rwb27/openflexure_nano_motor_controller/docs/hardware.rst

Sangaboard hardware
=====================
This module is designed to work with the "sangaboard" motor controller, 
based on an Arduino Nano and some Darlington pair ICs.  The PCB design
is available on Github, and can be ordered through WaterScope or via
`Kitspace`_.

.. _Kitspace: https://kitspace.org/boards/github.com/rwb27/openflexure_nano_motor_controller/
