rwb27/openflexure_nano_motor_controller/docs/source/openflexure_stage.rst

openflexure\_stage package
==========================

Submodules
----------

.. toctree::

   openflexure_stage.basic_serial_instrument
   openflexure_stage.stage

Module contents
---------------

.. automodule:: openflexure_stage
    :members:
    :undoc-members:
    :show-inheritance:
