rwb27/openflexure_nano_motor_controller/docs/source/openflexure_stage.stage.rst

openflexure\_stage.stage module
===============================

.. automodule:: openflexure_stage.stage
    :members:
    :undoc-members:
    :show-inheritance:
