rwb27/openflexure_nano_motor_controller/pcb_design/Schematic_v0.2.png

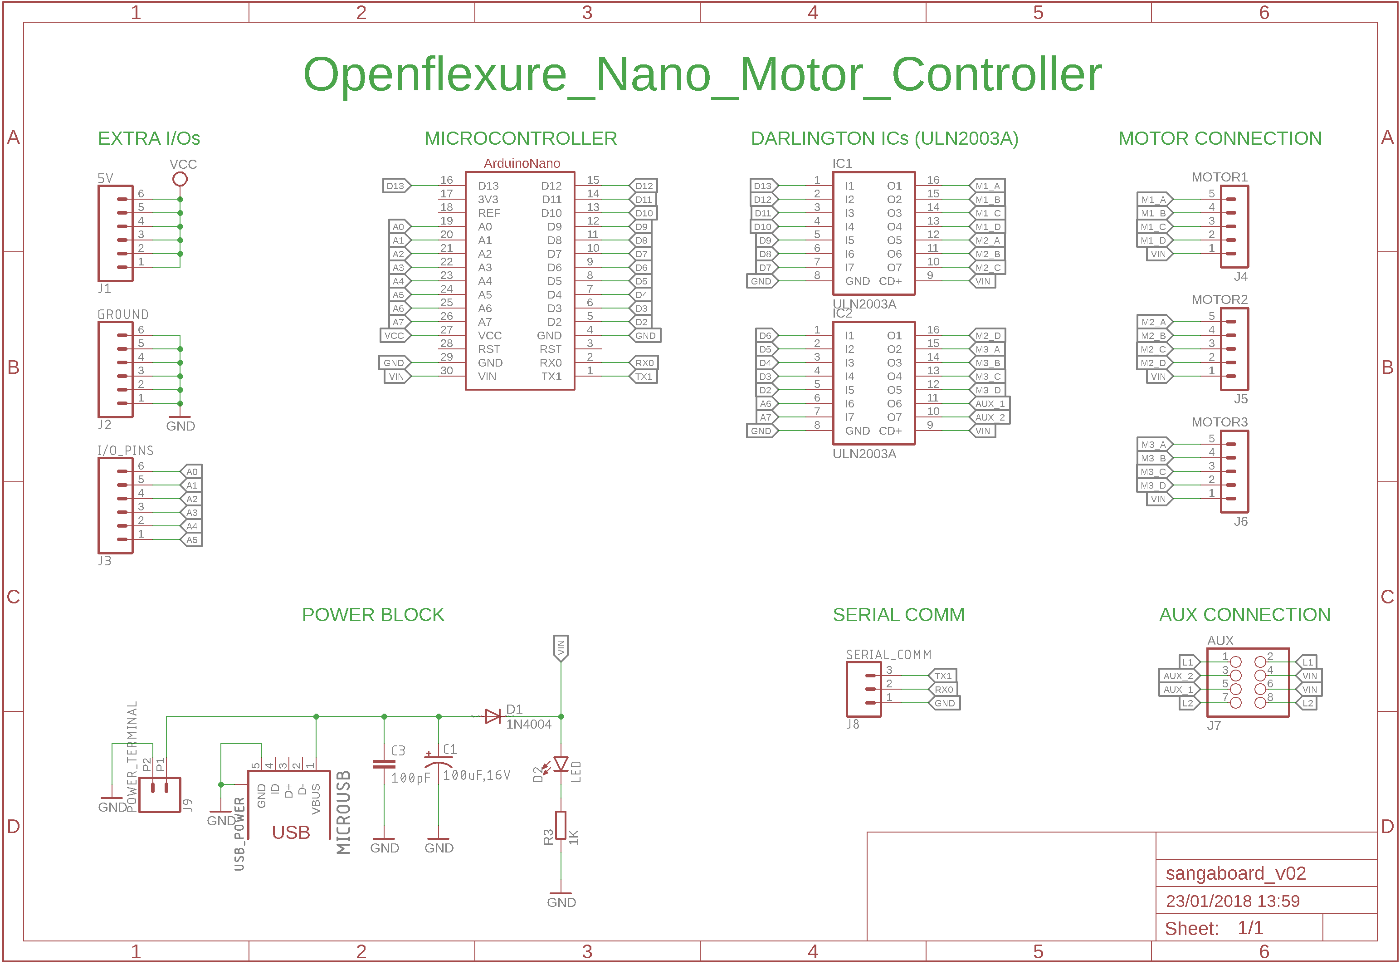
pcb_design/Schematic_v0.2.png
