rwb27/openflexure_nano_motor_controller/pcb_design/topView.png

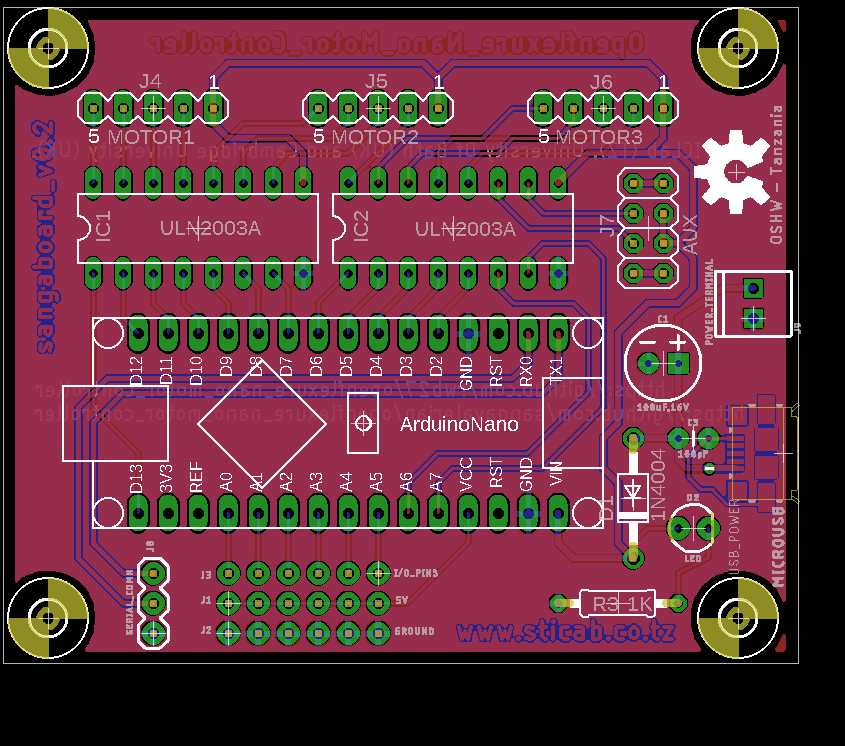
pcb_design/topView.png
