rwb27/openflexure_nano_motor_controller/(threads)

Thread 2 (2017-06-28):

Break out more pins

rwb27, 2017-06-28:
I’ve been thinking a bit more about this, and we might struggle for pins after all – Currently we have 14 channels of Darlington pair drivers (of which 12 are used).  Extra things we might like are:

1.	Limit switches (up to 3)
2.	LED control (using Darlington pair or, better, i2c-controlled digital potentiometers with constant-current drivers)
3.	Heater control (using one or two analogue pins plus a PWM pin for output, driving a power MOSFET)

The Nano has 14 digital pins of which 2 are the serial interface and 12 control the motors.  That leaves us 8 analogue pins to play with, which would be just enough to do the 3 things above, either using a digipot + constant current circuit for the LEDs or just the darlington pairs.

rwb27, 2017-10-03:
I think the two unused Darlington pairs are broken out now - though I don't know if that version has been uploaded (?)

rwb27, 2017-11-28:
I'm going to make a number of more specific issues for the next revision of the board.

rwb27, 2017-11-29:
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
While there are lots of nice suggestions for the next version, I think these are the most useful changes in the short term, and shouldn't be too much work...

sctv, 2017-12-11:
As few more suggestions.... for the future.

For LEDs you could use neopixels or similar.

https://create.arduino.cc/projecthub/whimsy-makerspace/arduino-compatible-nano-neopixel-controller-6f0c4b

On the nano analogue pins 1-6 can be used as digital if required ;)

"A0-A5 can be used as: analog input/digital input/digital output.
A6 and A7 are analog inputs only." (Via https://forum.arduino.cc/index.php?topic=502105.0

rwb27, 2017-12-13:
Thanks - that is useful.  I've shied away from the neopixels for the moment, largely because my experience with other multi-colour LEDs is that the colours come from different locations on the die - while that's not an issue in lighting/display applications, it can be a real pain in microscopy.

That said, we are looking at more sophisticated condenser designs that might include diffusers, at which point neopixels might be a very good option :)

sctv, 2017-12-14:
Its good to know about that disadvantage with multi led dies + microscopy.

On Wed, Dec 13, 2017 at 9:21 AM, Richard Bowman <notifications@github.com>
wrote:

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

--
----------------------------------------
Brian Degger
twitter: @drbrian

http://makerspace.org.uk
http://transitlab.org
----------------------------------------

sangavalerian, 2018-01-17:
thanks for the comments, i am finalizing version 0.2 of sangaboard (openflexure_nano_motor_controller). This time i have used eagle.

Thread 3 (2017-07-24):

Add Gerber files and BoM to repository

rwb27, 2017-07-24:
To get this made, most PCB houses need Gerber files, and a bill of materials.  It would be good to export these and put them in the repository.

rwb27, 2017-10-03:
Gerber files are here now.

rwb27, 2017-11-28:
I think this is now fixed - there should be everything we need to get it manufactured.

Closed 2017-11-28.

Thread 4 (2017-10-03):

ramp_time != 0 causes odd behaviour

rwb27, 2017-10-03:
setting ramp_time to a nonzero value seems to make the stage move back then forwards - this is odd...

rwb27, 2017-10-03:
actually, this is occurring even with ramp_time=0.  Maybe I've screwed up elsewhere...

rwb27, 2017-10-03:
oops! the error was in my Python code.  My backlash correction logic goes wrong when making steps smaller than the backlash amount.  Need to sort that out - I'll just turn it off for now.

Closed 2017-11-28.

Thread 11 (2017-11-28):

LED controller

rwb27, 2017-11-28:
It would be really useful to have a constant-current LED driver on the board.  A basic spec would be:
* 2 channels of illumination (more is a nice bonus but 2 is probably fine for now)
* adjustable current (ideally not using PWM).
  - Basic version: header pin to allow a resistor to be swapped in, and drive with 5v
  - Better version: integrate a trim pot
  - Best version: add an i2c digipot (if it's surface mount it might not cost much?)

Thread 12 (2017-11-28):

Heater control

rwb27, 2017-11-28:
It would be great to have 1-2 channels of heater control.  This probably wants some sort of digipot/pwm + MOSFET combination.  It needn't be fast, so sticking it on the i2c bus seems very sensible.  The mosfet probably needs to be beefy enough to handle a reasonable heater.  If this gets expensive, we could always keep it through-hole and solder them in as needed.

rwb27, 2018-07-05:
To add a thought: a digipot is probably a nice thing to use for analogue control of the heater (via a MOSFET, of course), and (given that we will likely want one for the LED) might save an IO pin or two as well.

Thread 13 (2017-11-28):

Break out i2c

rwb27, 2017-11-28:
We should include some header pins that allow i2c to be broken out for expansion.  Ideally it would be great to use a 6-pin header, and include 0v and 5v, so that an Adafruit TS2591 breakout board can be included.  Of course we could just include said sensor on our board, but it's not always needed and using the breakout is probably sensible.

rwb27, 2019-02-27:
Valerian did this in v2, and also (I believe) in v3

Closed 2019-02-27.

Thread 14 (2017-11-28):

Include ATMega 328

rwb27, 2017-11-28:
If we move to surface mount components, we could include the microcontroller (and other bits that make a Nano, i.e. the crystal, power supply, CH340 serial chip, and ISP connector).  This would make it smaller and cheaper.

codeTom, 2018-07-11:
Would this really be cheaper than the arduino? Cheapest Nano (unsoldered headers, on alibaba) is $0.34/pcs+shipping, atmega+ch340+quartz from cheapest alibaba suppliers are around $0.3 and unless it's assembled in china, shipping from different suppliers will likely make it much more expensive than buying the nano directly.

rwb27, 2018-07-19:
It's not so much about expense as about convenience - if we integrate the surface-mount components, then you don't need to solder on the Arduino - that means less assembly for us, and a smaller overall package (as you don't need to waste space for two boards stacked on top of each other or include 2.54mm headers).

This only makes sense if we're having the board populated - if we are assembling it ourselves, it almost certainly is better just to solder on a Nano.

rwb27, 2019-02-27:
This was replaced with a more capable microcontroller.

Closed 2019-02-27.

Thread 7 (2017-11-28):

Surface mount components

rwb27, 2017-11-28:
It would make things cheaper and smaller if we included the Nano in the design and used surface mount components throughout (with the possible exception of header pins).  It would also mean we can order PCBs populated from e.g. Seeed.

rwb27, 2019-02-27:
v3 now uses surface mount stuff.

Closed 2019-02-27.

Thread 8 (2017-11-28):

KiCAD PCB design

rwb27, 2017-11-28:
It would be good to use open software for the design, so that more people can contribute without buying licenses.  KiCAD seems like a really good option now.

rwb27, 2017-11-28:
It's been suggested that Eagle might be a good alternative - there is also a free version and an educational version, though it's not open source.  I am told it is probably easier to use, which I can believe, KiCAD is a bit of a monster!

rwb27, 2019-02-27:
v3 is now done using KiCAD - Valerian just needs to upload it.

Thread 23 (2018-07-05):

Integrate power/battery management

rwb27, 2018-07-05:
It is often useful to run the system from batteries.  While the 5v input theoretically lets us use a "power bank", the power from those is often pretty nasty (flickering LEDs, malfunctioning motors).  It would be better to integrate a battery management chip to regulate a LiPo cell.  Probably we'd want a solution that can handle both charging (ideally from a 5v or 12v input) and boost conversion to 5v (or higher) for running the Pi + motors + arduino + ...

Thread 25 (2018-07-05):

Support for endstop switches

rwb27, 2018-07-05:
It would be useful for a number of things (particularly fatigue testing) to have mechanical endstops on the microscope so we can reference a fixed "home" position.

Sebastian added [support for endstops using photointerruptors](https://github.com/sh969/openflexure_nano_motor_controller/commit/c1c5669789859795ab8227e4d41846bedb2adfaa) which did work for him, but I've not tested them.

rwb27, 2018-07-05:
If this became an [optional module](https://github.com/rwb27/openflexure_nano_motor_controller/commit/2b1151a8dfdd12d44ab455b411c64f45d12a50fc) that would seem to be a really neat way to do it...

Closed 2018-08-01.

Thread 30 (2018-07-20):

Make light sensor support a run-time decision

rwb27, 2018-07-20:
Currently support for the light sensor has to be compiled in.  It would be great to be able to set this at runtime, and I can't see why that's a bad idea...

codeTom, 2018-07-25:
The obvious drawback is it will use more program memory (with both adafruit libraries we're at ~65%, help strings take a lot), it also adds some global variables, ~300 extra bytes (we would still have ~960 bytes left), both of these should be fine now, but if more light sensors or other features are added, we might run out of memory.
Whoever is building the microscopes will need to flash the firmware anyway, so selecting the configuration they are building should not be a problem (we can separate the config to a separate file if that makes it easier).

rwb27, 2018-07-25:
yeah, that's probably why it's a bad idea.  It might save a few seconds for lazy people (AKA me) but it's not a big problem.  It's not like flashing the firmware is hard in any case.  I think I'll close this one for now.
