rwb27/openflexure_nano_motor_controller/pcb_design/sangaboard_v02.brd

## EAGLE design pcb_design/sangaboard_v02.brd (2018-07-05)

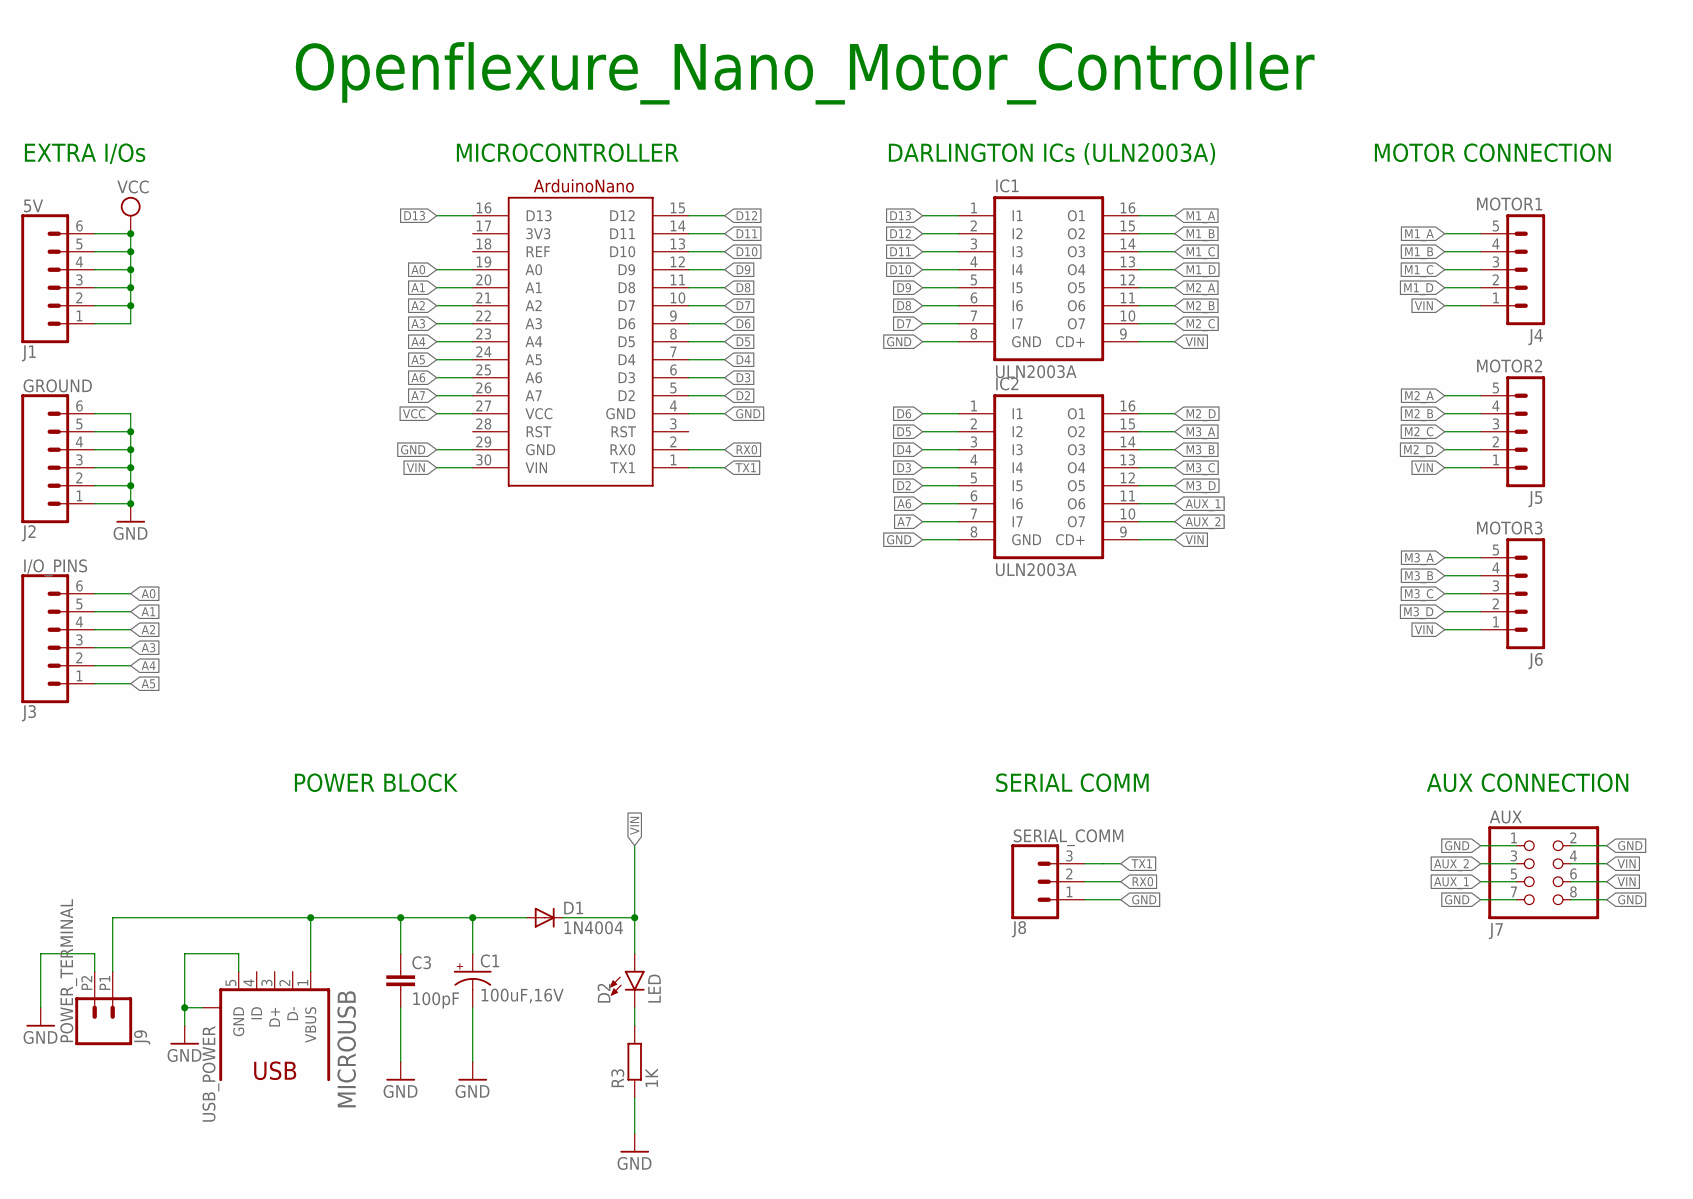
[picture p4: schematic sangaboard_v02.sch]

Parts:
5V: J1; 1X06_NO_SILK
A1: Arduino Nano; ARDUINONANO
AUX: J7; 2X04
C1: 100uF,16V; CPOL-RADIAL-2.5MM-6.5MM
C3: 100pF; CAP-PTH-2.54
D1: 1N4004; DO41-10
D2: LED; LED_3MM
GROUND: J2; 1X06_NO_SILK
I/O_PINS: J3; 1X06_NO_SILK
IC1, IC2: ULN2003A; DIL16
MICROUSB: USB_POWER; 1981584-1
MOTOR1: J4; MA05-1
MOTOR2: J5; MA05-1
MOTOR3: J6; MA05-1
POWER_TERMINAL: J9; 1X02_2.54_SCREWTERM
R3: 1K; 0207/10
SERIAL_COMM: J8; 1X03

Connections:
3V3: A1.17 (3V3)
A0: A1.19 (A0), I/O_PINS.6
A1: A1.20 (A1), I/O_PINS.5
A2: A1.21 (A2), I/O_PINS.4
A3: A1.22 (A3), I/O_PINS.3
A4: A1.23 (A4), I/O_PINS.2
A5: A1.24 (A5), I/O_PINS.1
A6: A1.25 (A6), IC2.6 (I6)
A7: A1.26 (A7), IC2.7 (I7)
AUX_1: AUX.5, IC2.11 (O6)
AUX_2: AUX.3, IC2.10 (O7)
D2: A1.5 (D2), IC2.5 (I5)
D3: A1.6 (D3), IC2.4 (I4)
D4: A1.7 (D4), IC2.3 (I3)
D5: A1.8 (D5), IC2.2 (I2)
D6: A1.9 (D6), IC2.1 (I1)
D7: A1.10 (D7), IC1.7 (I7)
D8: A1.11 (D8), IC1.6 (I6)
D9: A1.12 (D9), IC1.5 (I5)
D10: A1.13 (D10), IC1.4 (I4)
D11: A1.14 (D11), IC1.3 (I3)
D12: A1.15 (D12), IC1.2 (I2)
D13: A1.16 (D13), IC1.1 (I1)
GND: A1.4 (GND), A1.29 (GND), AUX.1, AUX.2, AUX.7, AUX.8, C1.2 (-), C3.2, GROUND.1, GROUND.2, GROUND.3, GROUND.4, GROUND.5, GROUND.6, IC1.8 (GND), IC2.8 (GND), MICROUSB.5 (GND), MICROUSB.S1, POWER_TERMINAL.P2 (2), R3.1, SERIAL_COMM.1
M1_A: IC1.16 (O1), MOTOR1.5
M1_B: IC1.15 (O2), MOTOR1.4
M1_C: IC1.14 (O3), MOTOR1.3
M1_D: IC1.13 (O4), MOTOR1.2
M2_A: IC1.12 (O5), MOTOR2.5
M2_B: IC1.11 (O6), MOTOR2.4
M2_C: IC1.10 (O7), MOTOR2.3
M2_D: IC2.16 (O1), MOTOR2.2
M3_A: IC2.15 (O2), MOTOR3.5
M3_B: IC2.14 (O3), MOTOR3.4
M3_C: IC2.13 (O4), MOTOR3.3
M3_D: IC2.12 (O5), MOTOR3.2
unnamed: D2.K (C), R3.2
unnamed: C1.1 (+), C3.1, D1.A, MICROUSB.1 (VBUS), POWER_TERMINAL.P1 (1)
REF: A1.18 (REF)
RX0: A1.2 (RX0), SERIAL_COMM.2
TX1: A1.1 (TX1), SERIAL_COMM.3
VCC: 5V.1, 5V.2, 5V.3, 5V.4, 5V.5, 5V.6, A1.27 (VCC)
VIN: A1.30 (VIN), AUX.4, AUX.6, D1.C, D2.A, IC1.9 (CD+), IC2.9 (CD+), MOTOR1.1, MOTOR2.1, MOTOR3.1

Notes on the sheet:
MICROCONTROLLER
EXTRA I/Os
DARLINGTON ICs (ULN2003A)
POWER BLOCK
MOTOR CONNECTION
AUX CONNECTION
SERIAL COMM
Openflexure_Nano_Motor_Controller

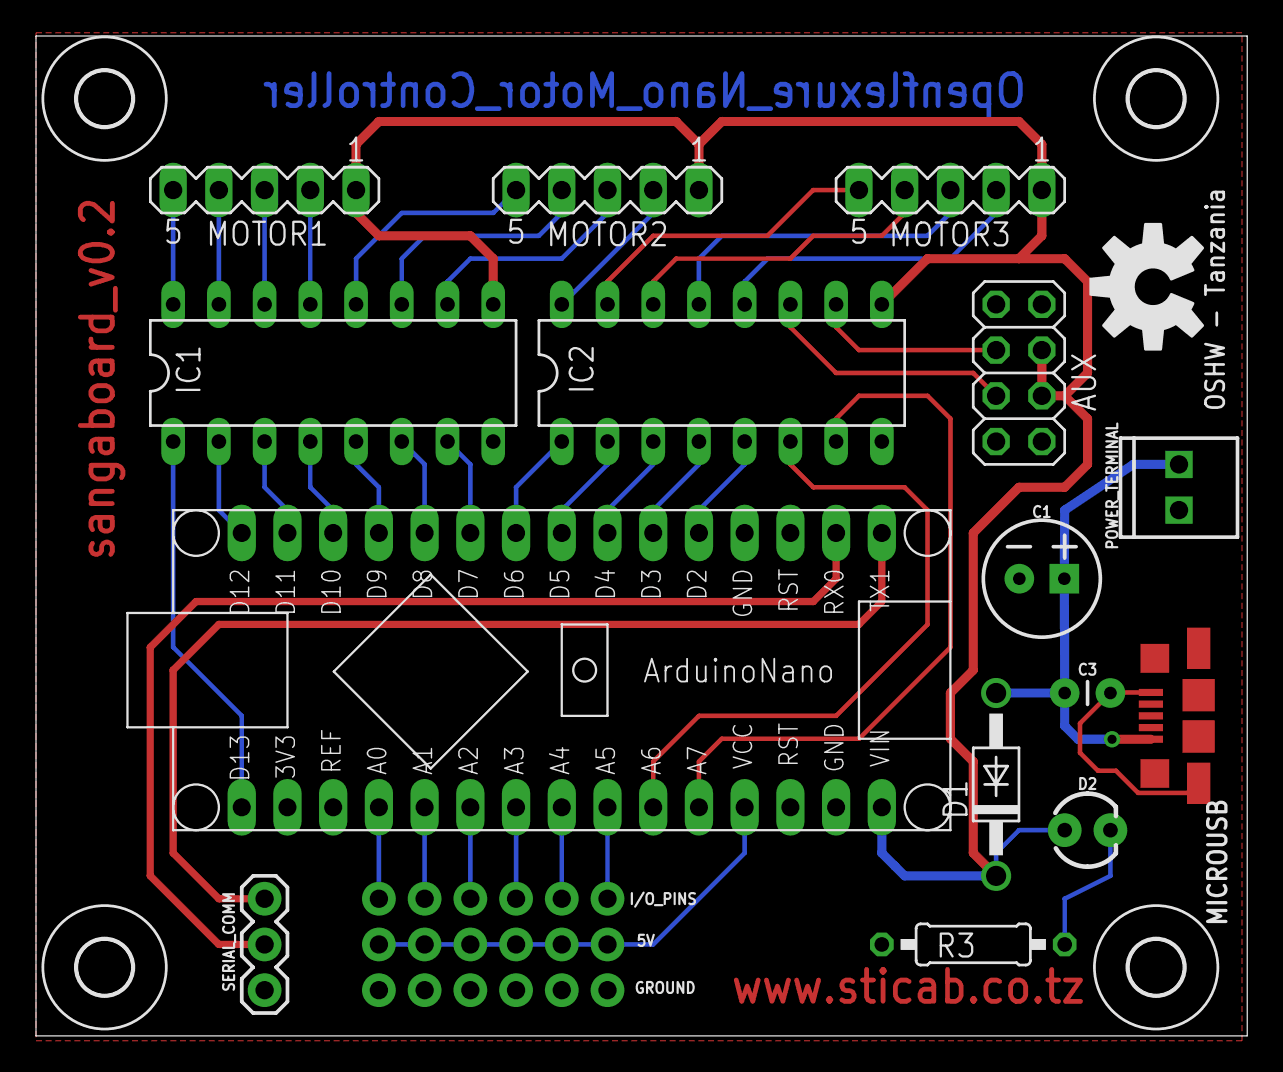
[picture p5: board sangaboard_v02.brd from above]

Board: 2 copper layers, 67.3 x 55.5 mm, 23 parts (0 on the bottom side), 41 nets.

Other parts of the board:
U$1, U$2, U$3, U$4: 3,0
U$5: OSHW-LOGO-L
