rwb27/openflexure_nano_motor_controller/(commit log)

2017-06-19 Initial version of Arduino firmware and host Python code
    Currently only single-axis relative moves (rmx <steps> for x in x, y, z)
    work, though you can also get position (p?) and disable the steppers
    (release).
2017-06-27 Add files via upload
    This PCB has been designed using Proteus Software.
    [OpenFlexure Motor Controller PCB V0_1.pdsprj]
2017-07-06 Credited prior art
    The PCB design was Valerian's, but my code was copy-pasted. Mostly from the arduino based motor controller I wrote myself, but from a few other places too; and it's important to acknowledge them...
2017-07-25 optimised and added persistence
    It now handles changing parameters on the fly, nice acceleration, and
    remembers where you left it after a power cycle!
2017-07-25 Settings now persist
    min_step_delay and ramp_time are now saved to EEPROM so they won't get
    lost on restart :)
    [openflexure_nano_motor_controller.ino]
2017-09-20 Added Valerian's Gerber files
    [microscopeOffice.pdsprj]
2017-11-20 Pasted in StepperF_alt
    I nastily hacked Fergus's mod of the Stepper library so I could make this work. TODO: make this neater!
2017-11-20 fixed type issue
    command_prefix takes a char** argument - now correctly declared as const.
    [openflexure_nano_motor_controller.ino]
2017-11-20 Revert "fixed type issue"
    This reverts commit c5333327fc0691ef8fdb637eeb7369b5fe947a9b.
    [openflexure_nano_motor_controller.ino]
2017-11-20 Adafruit TSL2591 Support
    Wrote some very basic functions to support light sensor use with a hacked SANGABOARD, on I2C. Should really break out the header pins for this properly - but for now, I've just soldered onto them from the bottom.
2017-11-20 Made light sensor responses consistent
    light sensor responses are now consistent with other properties.
2017-11-20 removed colons from light sensor responses
2017-11-28 Turned off TSL2591 support by default
    also made the help string refer to the light sensor only if it is enabled.
2017-12-11 Added support for ADS1115 light sensor
2017-12-11 turned off light sensor support by default
2018-02-02 sangaboard_v0.2
    The new version of openflexure nano motor controller (sangaboard_v0.2) with the consideration of comments given on the first design.
    The design is made using Eagle.
    [sangaboard_v02.brd, sangaboard_v02.sch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]
2018-02-09 Fixed initial line bug
    The stage now correctly prints exactly one line when it starts.
    [openflexure_nano_motor_controller.ino]
2018-03-07 Make compatible with kitspace.org
    [1-click-bom.tsv]
2018-03-08 Switch kitspace input to sangaboard
    [1-click-bom.tsv]
2018-03-09 Select parts for BOM
    [1-click-bom.tsv]
2018-03-27 Upated bugfix for query code if unexpected items appear in buffer between write and read
    Also:
    * Updated .gitignore for some linux stuff
    * Deleted stray .pyc file
    * Moved StepperF_alt files so automatically found by Arduino IDE
    * Updated arduino readme with a little info
    [basic_serial_instrument.py, openflexure_nano_motor_controller.ino, stage.py]
2018-03-27 Modified Arduino code to allow more than 32767 steps in one go
2018-03-27 Improved help and light sensor support
    * All Adafruit libraries included as installed libraries with <>
    * Added instructions for installing adafruit libraries into ReadMe
    * Defined version string in .ino, as light sensors/help used no/wrong version number
    * Cleaned up help string formatting
    * Added help file termination line "--END--" to allow multiline read
    * Added function in python to print help: OpenFlexureStage.print_help()
    * Added variable "OpenFlexureStage.board" for checking board firmware
    * Added error message when board firmware is incorrect to display firmware version
    [openflexure_nano_motor_controller.ino, stage.py]
2018-03-27 Partial support for light sensor in python, should add intensity QueriedProperty
2018-03-28 New OptionalModule class, LightSensor now an OptionalModule
    * Arduino now has method for listing installed modules
    * BasicSerialInstrument now warns when parsed_query has to make multiple reads to get match
    * New class OptionalModule for optional modules on serial instruments
    * QueriedProperty recognises OptionalModule objects and points BasicSerialInstrument calls to OptionalModule.parent
    * LightSensor class (sub class of OptionalModule) added
    * LightSensor class uses a combination of the code from my hacked light sensor
    and from the old light sensor code to be all properties but also to have
    better error checking
    * Python probes optional modules and adds them if recognised
    * Remove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
    [basic_serial_instrument.py, openflexure_nano_motor_controller.ino, stage.py]
2018-06-06 Updated Bottom Layer
    Have updated the Aux header pin connection to Ground.
    [sangaboard_v02.brd, sangaboard_v02.sch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]
2018-07-05 Fix gerber path in kitspace.yaml
2018-07-05 Re-plot gerbers using oshpark cam job
    http://docs.oshpark.com/design-tools/eagle/generating-gerbers/
    [gerber_job.gbrjob, sangaboard_v02.drills.xln]
2018-07-05 Replace pcb_design with sangaboard
    [1-click-bom.tsv, OpenFlexure Motor Controller PCB V0_1.pdsprj, microscopeOffice.pdsprj, sangaboard_v02.brd, sangaboard_v02.sch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]
2018-07-06 fix python3 print missed when merging
    [basic_serial_instrument.py]
2018-07-06 remove debug print
2018-07-11 fix micros() overflow in StepperF
    micros() overflows in ~ 70min, stepperF now checks for the overflow
    and adjusts the timing.
2018-07-11 fix micros() overflow in move_axes
    micros() overflows after ~70 min, this should handle the overflow correctly.
    [openflexure_nano_motor_controller.ino]
2018-07-12 basic endstop support
2018-07-20 arduino: support for endstops
2018-07-20 Improved error handling if board is set up badly
    The light sensor error message is now printed before the board ID, so that it causes an error. This could probably be done more elegantly, but it's ok for now.
    I've also added error handling to the constructor so it doesn't leave the port open in the event that we can't initialise the board.
    [openflexure_nano_motor_controller.ino, stage.py]
2018-07-20 Updated versions and error checking
    The code will now raise an exception if the version is wrong in the firware version string, and point to the docs describing how to fix it.
    [openflexure_nano_motor_controller.ino, stage.py]
2018-07-20 arduino: endstop related fixes
    Prevents move_axes from changing its argument, several other endstop fixes.
    [openflexure_nano_motor_controller.ino]
2018-07-23 Endstops OptionalModule in openflexure_stage
    Endstops module can query endstop status, home axes, and set maxima for software
    endstops.
    Some minor changes to arduino code.
2018-07-25 documentation for Endstops
2018-07-25 Endstop description in docs
2018-07-25 endstops: support homing given axes
2018-07-25 endstops: remove unnecessary goto
2018-07-26 endstops: only respond after homing
    Removed some debug prints and added "done" print after homing so that the stage
    waits for homing to finish.
    Also fixes intermittent issue with software endstops resetting current position.
    [openflexure_nano_motor_controller.ino]
2018-07-26 endstops: fix returning hit endstop with min+soft
    Using compiler directives in the an else statement with no brackets meant that
    if min+soft endstops are used, hit endstop was not returned from move_axes.
    [openflexure_nano_motor_controller.ino]
2018-07-31 endstops: slower fine homing
2018-07-31 endstops: home axes argument format in help
2018-08-09 Add test mode
    Stage now has a test_mode property which is propagated to modules and the firmware.
    With test_mode on the stage will return more data about the homing procedure, will
    stay at 0 after homing and will not reset position when it hits an endstop.
    This property may be used in the future to report more data/change other behaviour
    as required for testing.
    [openflexure_nano_motor_controller.ino, stage.py]
2018-08-23 Sangaboard v0.3 support
    Sangaboard v0.3 controller uses different pins to control the motors, this adds
    a define to select the version.
    The microcontroller on this board does not reset on new serial connections, so
    a version command was addded and openflexure_stage will query the firmware
    version. This means the new openflexure_stage is incompatible with older firmware.
    [openflexure_nano_motor_controller.ino, stage.py]
2019-02-22 Fixed mistake in arduino help string
    [openflexure_nano_motor_controller.ino]
